MichaelThom/Wordclock/README.md

# Wordclock
Creating a Wordclock with Raspberry Pi and adafruit 32x32 RGB Display
