MichaelThom/Wordclock/CAD Data/Aussengehäuse.pdf

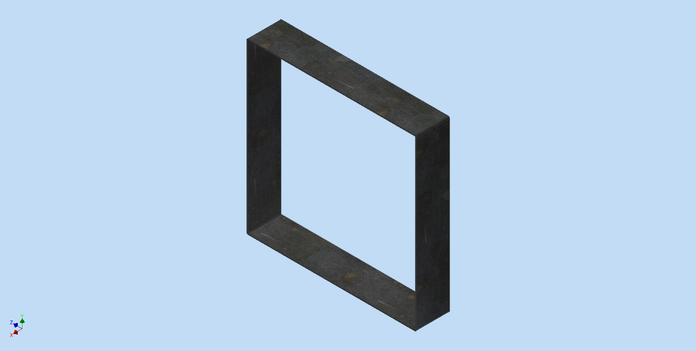
[picture p1: page 1]
