MichaelThom/Wordclock/CAD Data/Frontplatte.pdf

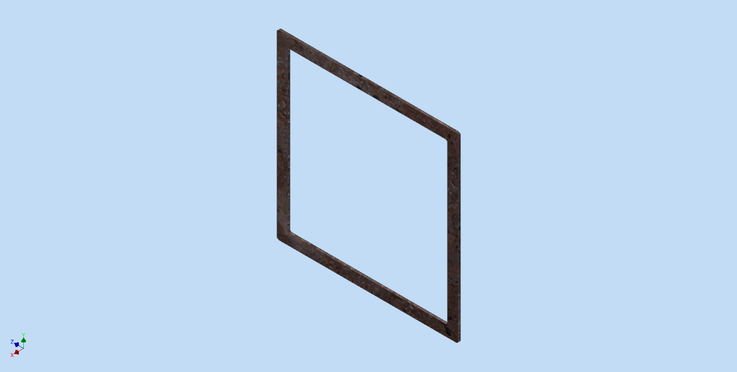
[picture p2: page 1]
