MichaelThom/Wordclock/CAD Data/Gehäuse komplett.pdf

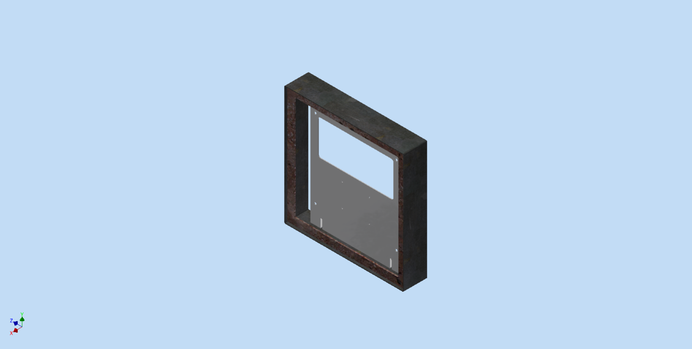
[picture p3: page 1]
