MichaelThom/Wordclock/CAD Data/Innengehäuse gebogen.pdf

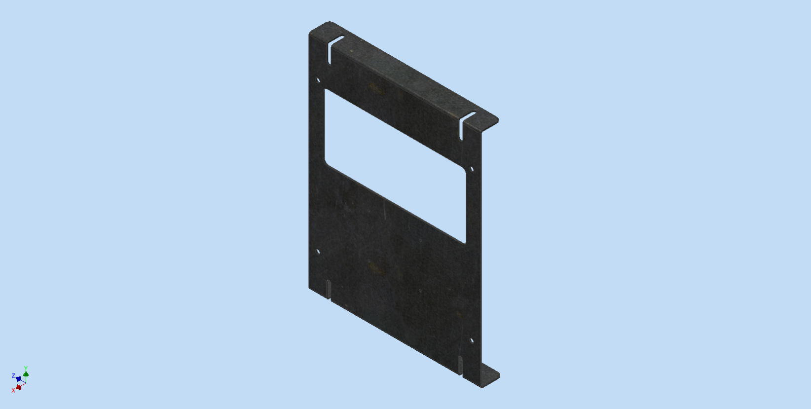
[picture p4: page 1]
