MichaelThom/Wordclock/CAD Data/Frontplatte.stp

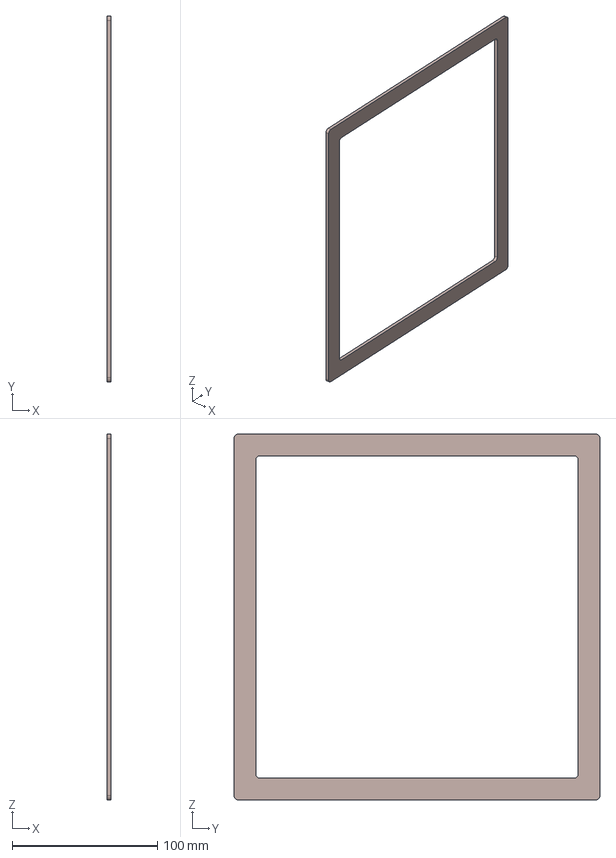
[picture p5: CAD file, 2015-06-04]
CAD Data/Frontplatte.stp
3.00 x 252.0 x 252.0 mm
