MichaelThom/Wordclock/CAD Data/Innengehäuse.stp

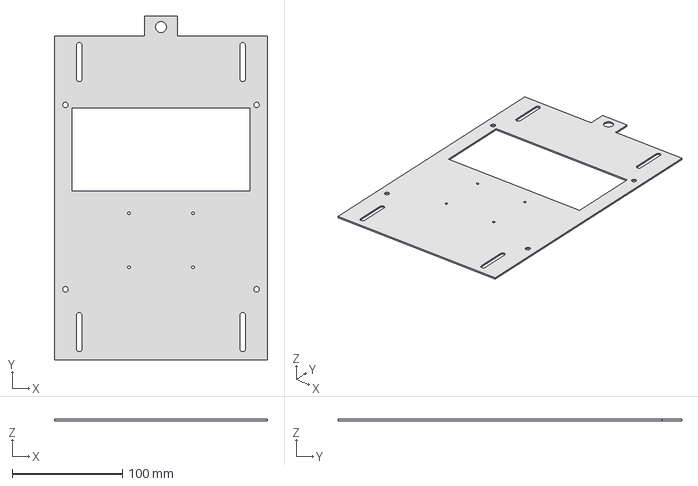
[picture p6: CAD file, 2015-06-04]
CAD Data/Innengehäuse.stp
193.0 x 311.5 x 1.50 mm
