MichaelThom/Wordclock/CAD Data/Gehäuse komplett.stp

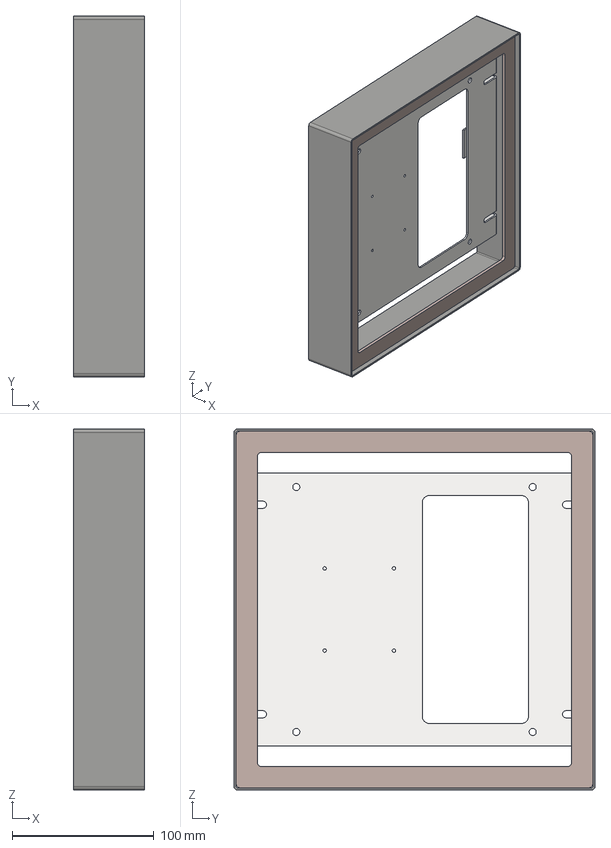
[picture p7: CAD file, 2015-06-04]
CAD Data/Gehäuse komplett.stp
50.0 x 255.0 x 255.0 mm
Aussengehäuse
Frontplatte
Innengehäuse gebogen
