MichaelThom/Wordclock/CAD Data/Innengehäuse gebogen.stp

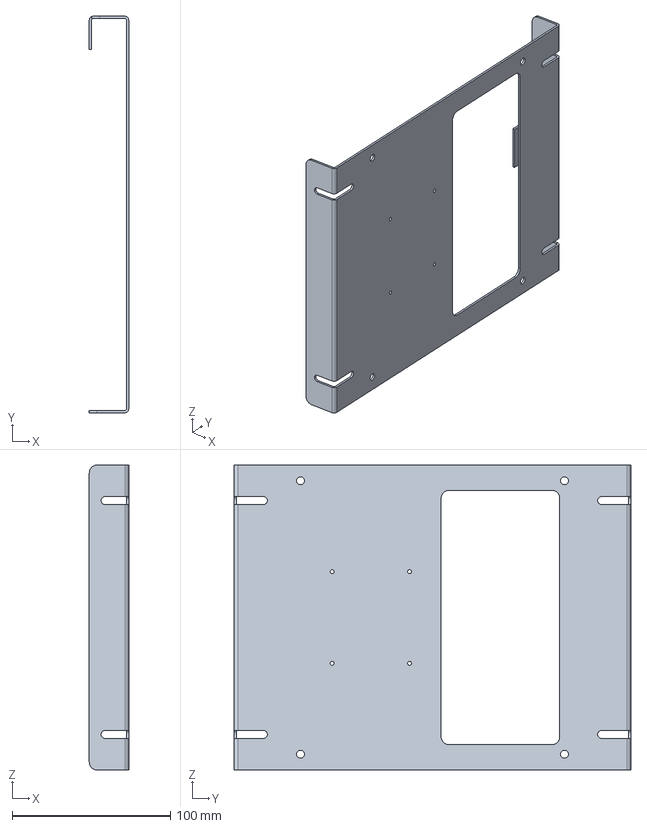
[picture p8: CAD file, 2015-06-04]
CAD Data/Innengehäuse gebogen.stp
25.0 x 251.0 x 193.0 mm
