MichaelThom/Wordclock/CAD Data/Aussengehäuse.stp

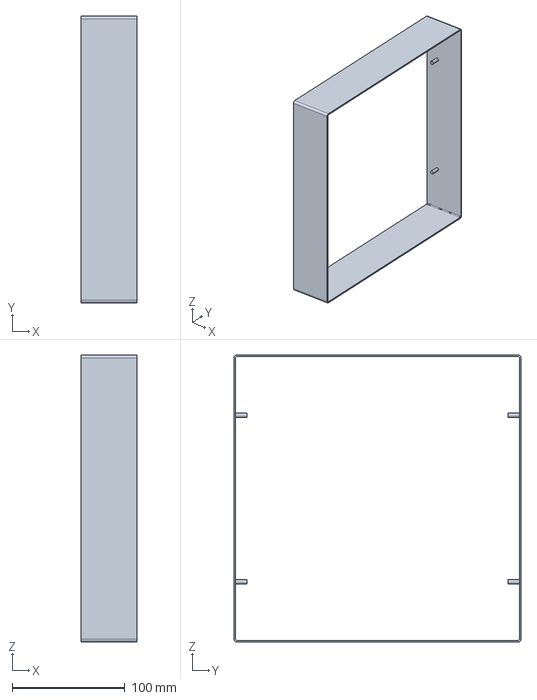
[picture p9: CAD file, 2015-06-04]
CAD Data/Aussengehäuse.stp
50.0 x 255.0 x 255.0 mm
