MichaelThom/Wordclock/(list of files, cad)

Other CAD files:
CAD Data/Aussengehäuse.ipt
CAD Data/Frontplatte.ipt
CAD Data/Gehäuse komplett.dwg
CAD Data/Gehäuse komplett.iam
CAD Data/Innengehäuse gebogen.ipt
CAD Data/Innengehäuse.ipt
