MichaelThom/Wordclock/CAD Data/Gehäuse Zusammenstellung.pdf

A-A ( 1 : 1 )

A

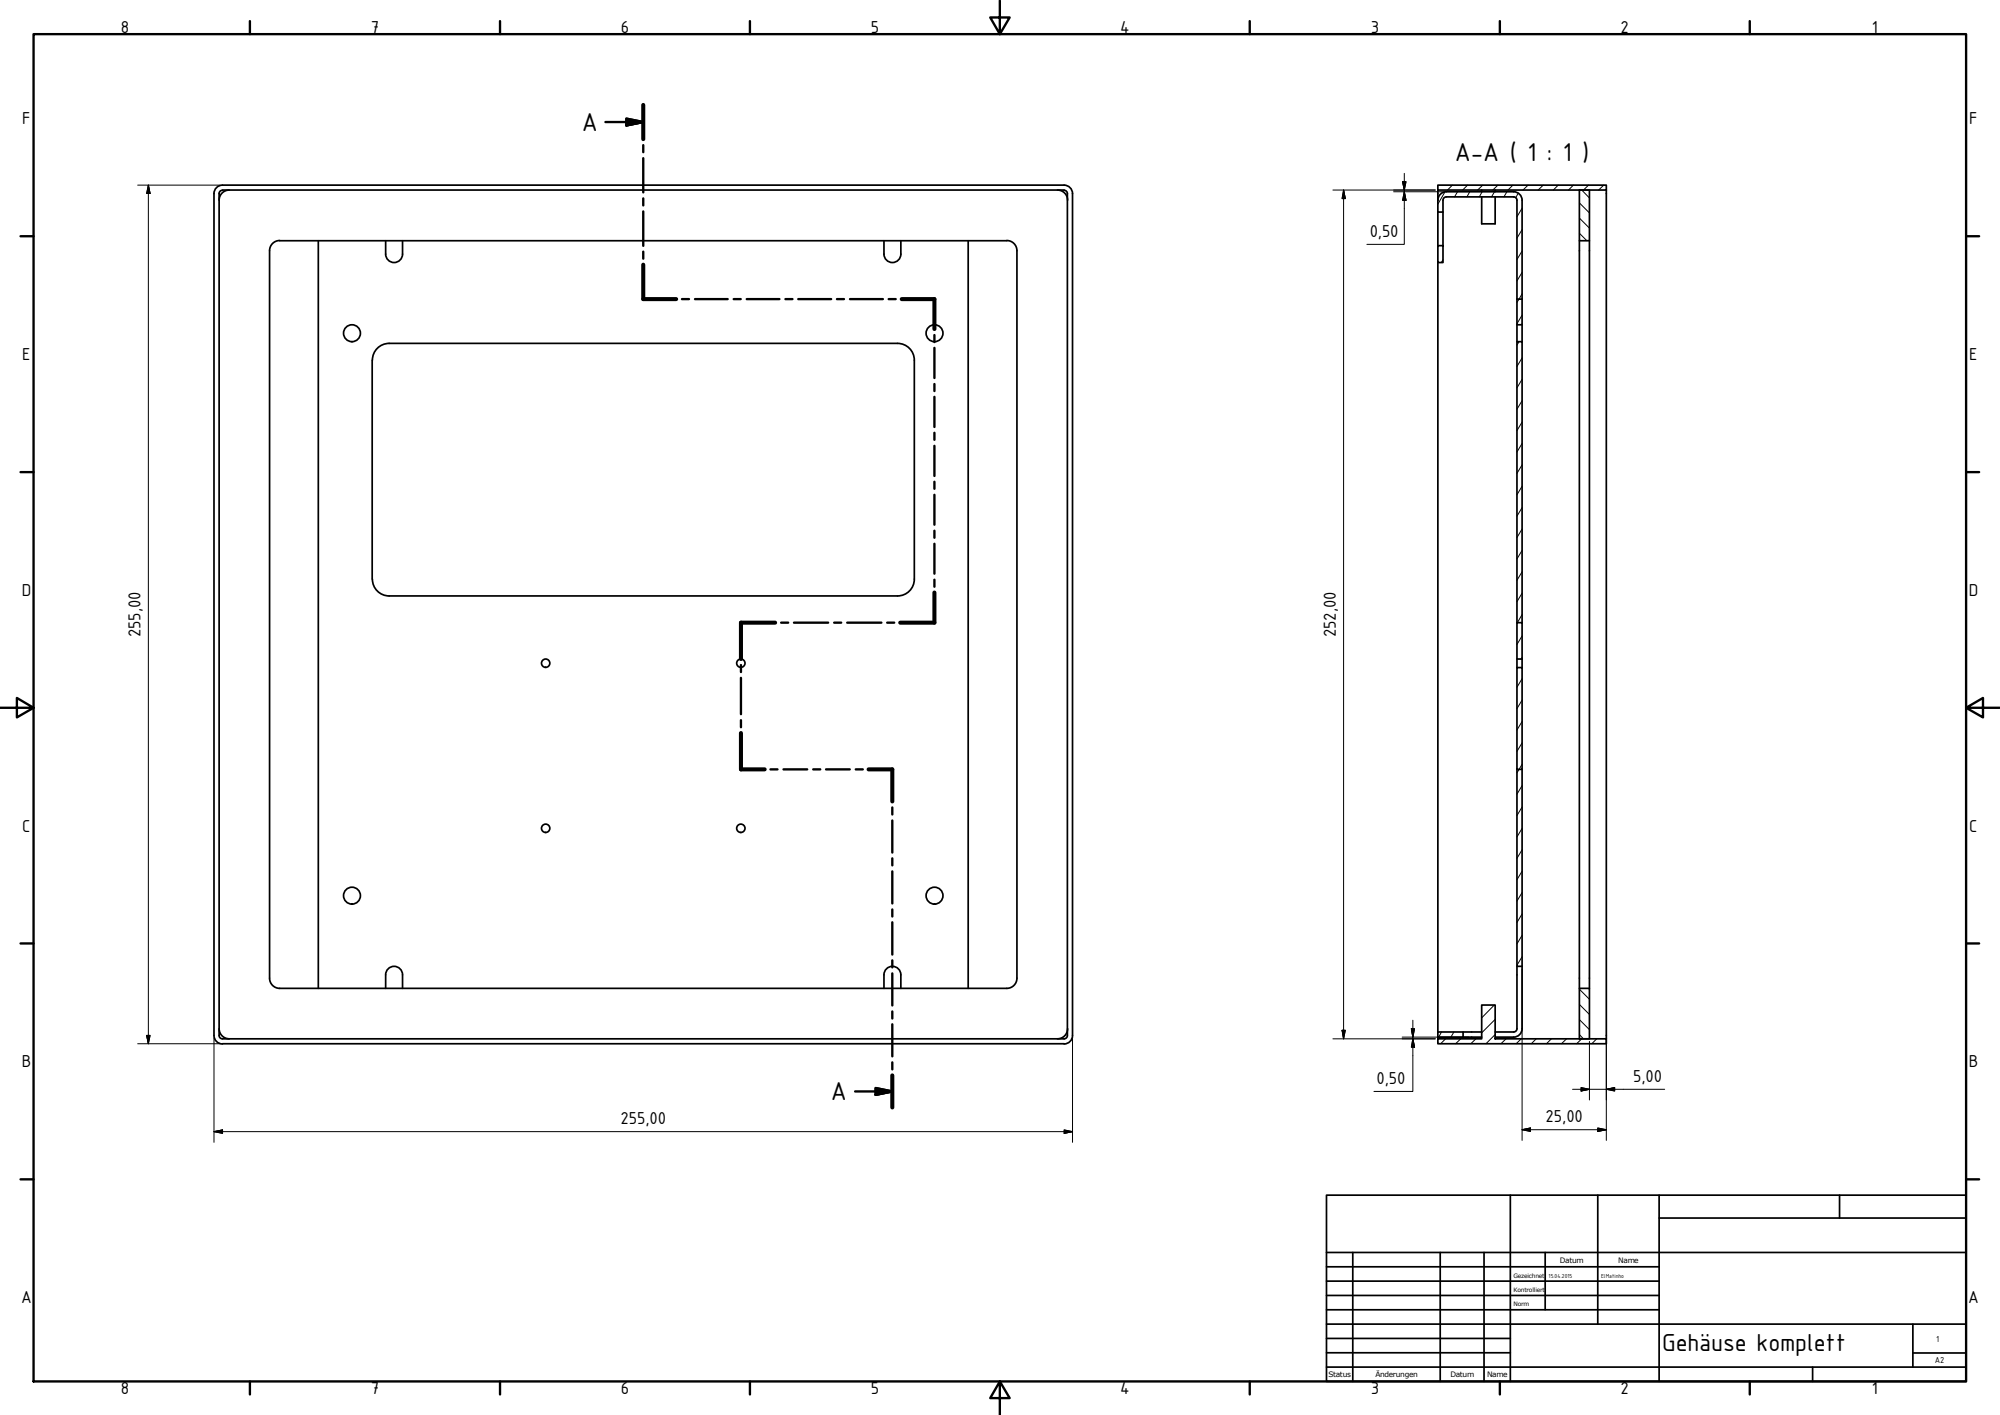
[picture p10: page 1]
Status; bnderungen; Datum; Name; Gezeichnet; Kontrolliert; Norm; ElMatinho

Gehuse komplett
