MichaelThom/Wordclock/CAD Data/Zifferblatt Schwarz.pdf

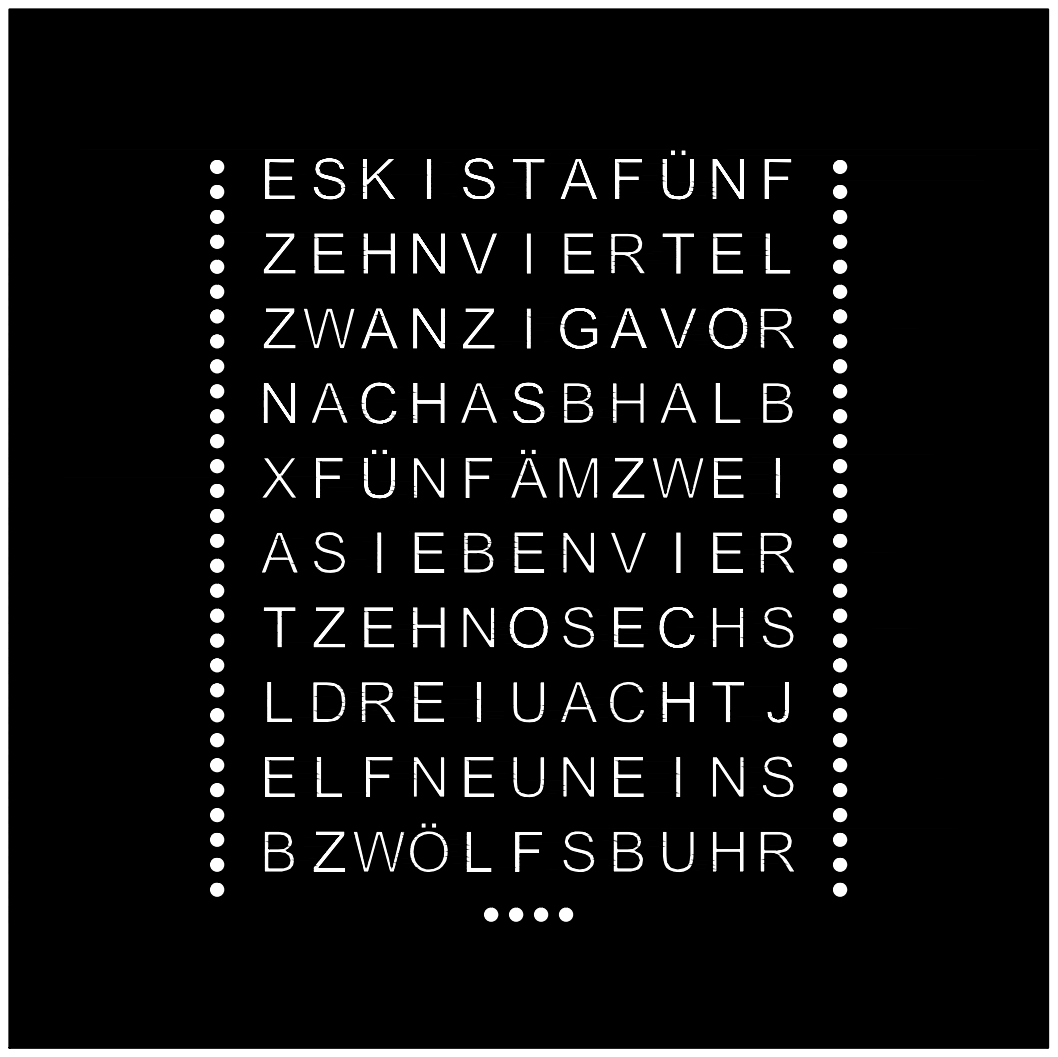
[picture p13: page 1]
