MichaelThom/Wordclock/clock.py

# Datei muss clock.py heissen !!!
def esIst(table):
        for n in range(0, 2):
                for m in range (5, 9):
                        table [n][m] = 1
        for n in range(0, 2):
                for m in range (12, 17):
                        table [n][m] = 1

def fuenf(table):
        for n in range(0, 2):
                for m in range (20, 27):
                        table [n][m] = 1

def zehn(table):
        for n in range(3, 5):
                for m in range (5, 13):
                        table [n][m] = 1

def zwanzig(table):
        for n in range(3, 5):
                for m in range (14, 27):
                        table [n][m] = 1

def drei(table):
        for n in range(6, 8):
                for m in range (5, 13):
                        table [n][m] = 1

def viertel(table):
        for n in range(6, 8):
                for m in range (14, 27):
                        table [n][m] = 1


def vor(table):
         for n in range(9, 11):
                for m in range (5, 11):
                        table [n][m] = 1

def nach(table):
         for n in range(9, 11):
                for m in range (12, 20):
                        table [n][m] = 1

def vor(table):
         for n in range(9, 11):
                for m in range (5, 11):
                        table [n][m] = 1

def nach(table):
         for n in range(9, 11):
                for m in range (19, 27):
                        table [n][m] = 1

def halb(table):
         for n in range(12, 14):
                for m in range (5, 13):
                        table [n][m] = 1

def hElf(table):
         for n in range(12, 14):
                for m in range (15, 21):
                        table [n][m] = 1

def hFuenf(table):
         for n in range(12, 14):
                for m in range (19, 27):
                        table [n][m] = 1

def hEins(table):
         for n in range(16, 17):
                for m in range (5, 13):
                        table [n][m] = 1

def hZwei(table):
         for n in range(16, 17):
                for m in range (19, 27):
                        table [n][m] = 1

def hDrei(table):
         for n in range(18, 19):
                for m in range (5, 13):
                        table [n][m] = 1

def hVier(table):
         for n in range(18, 19):
                for m in range (19, 27):
                        table [n][m] = 1


def hSechs(table):
         for n in range(21, 22):
                for m in range (5, 15):
                        table [n][m] = 1

def hAcht(table):
         for n in range(21, 22):
                for m in range (19, 27):

def hSieben(table):
         for n in range(24, 25):
                for m in range (5, 17):
                        table [n][m] = 1

def hZwoelf(table):
         for n in range(24, 25):
                for m in range (17, 27):
                        table [n][m] = 1

def hZehn(table):
         for n in range(27, 28):
                for m in range (5, 13):
                        table [n][m] = 1

def hNeun(table):
         for n in range(27, 28):
                for m in range (11, 19):

def uhr(table):
         for n in range(27, 28):
                for m in range (21, 27):
                        table [n][m] = 1
